mgvargas/imsas/README.md

Amplifier circuit

This project contains an amplifier board and schematics used to amplify the signal from 9 half Wheatstone bridge sensors. All files were created in KiCad.
