mgvargas/imsas/Amplifier_Circuit-V2/SensorArray_v2.pdf

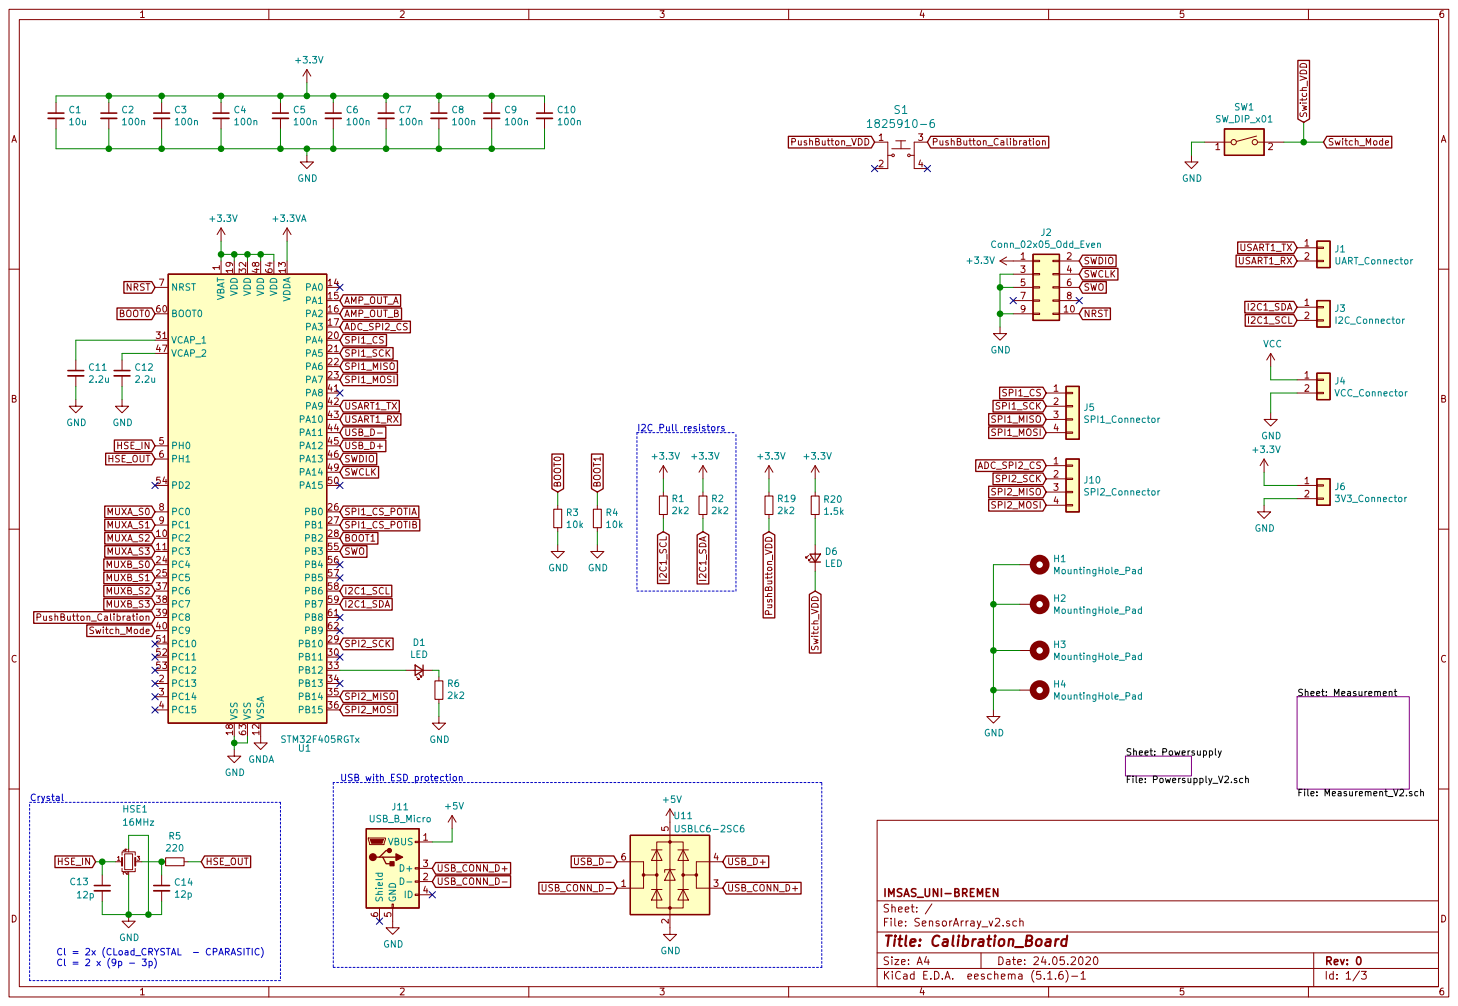
[picture p2: page 1]

1 PC2 10 PC3 11 VSSA 12 VDDA 13 PA0 14 PA1 15 PA2 16 PA3 17 VSS 18 VDD 19 PC13 2 PA4 20 PA5 21 PA6 22 PA7 23 PC4 24 PC5 25 PB0 26 PB1 27 PB2 28 PB10 29 PC14 3 PB11 30 VCAP_1 31 VDD 32 PB12 33 PB13 34 PB14 35 PB15 36 PC6 37 PC7 38 PC8 39 PC15 4 PC9 40 PA8 41 PA9 42 PA10 43 PA11 44 PA12 45 PA13 46 VCAP_2 47 VDD 48 PA14 49 PH0 5 PA15 50 PC10 51 PC11 52 PC12 53 PD2 54 PB3 55 PB4 56 PB5 57 PB6 58 PB7 59 PH1 6 BOOT0 60 PB8 61 PB9 62 VSS 63 VDD 64 NRST 7 PC0 8 PC1 9 U1 STM32F405RGTx R6

Sheet: Measurement File: Measurement_V2.sch Sheet: Powersupply

USB with ESD protection

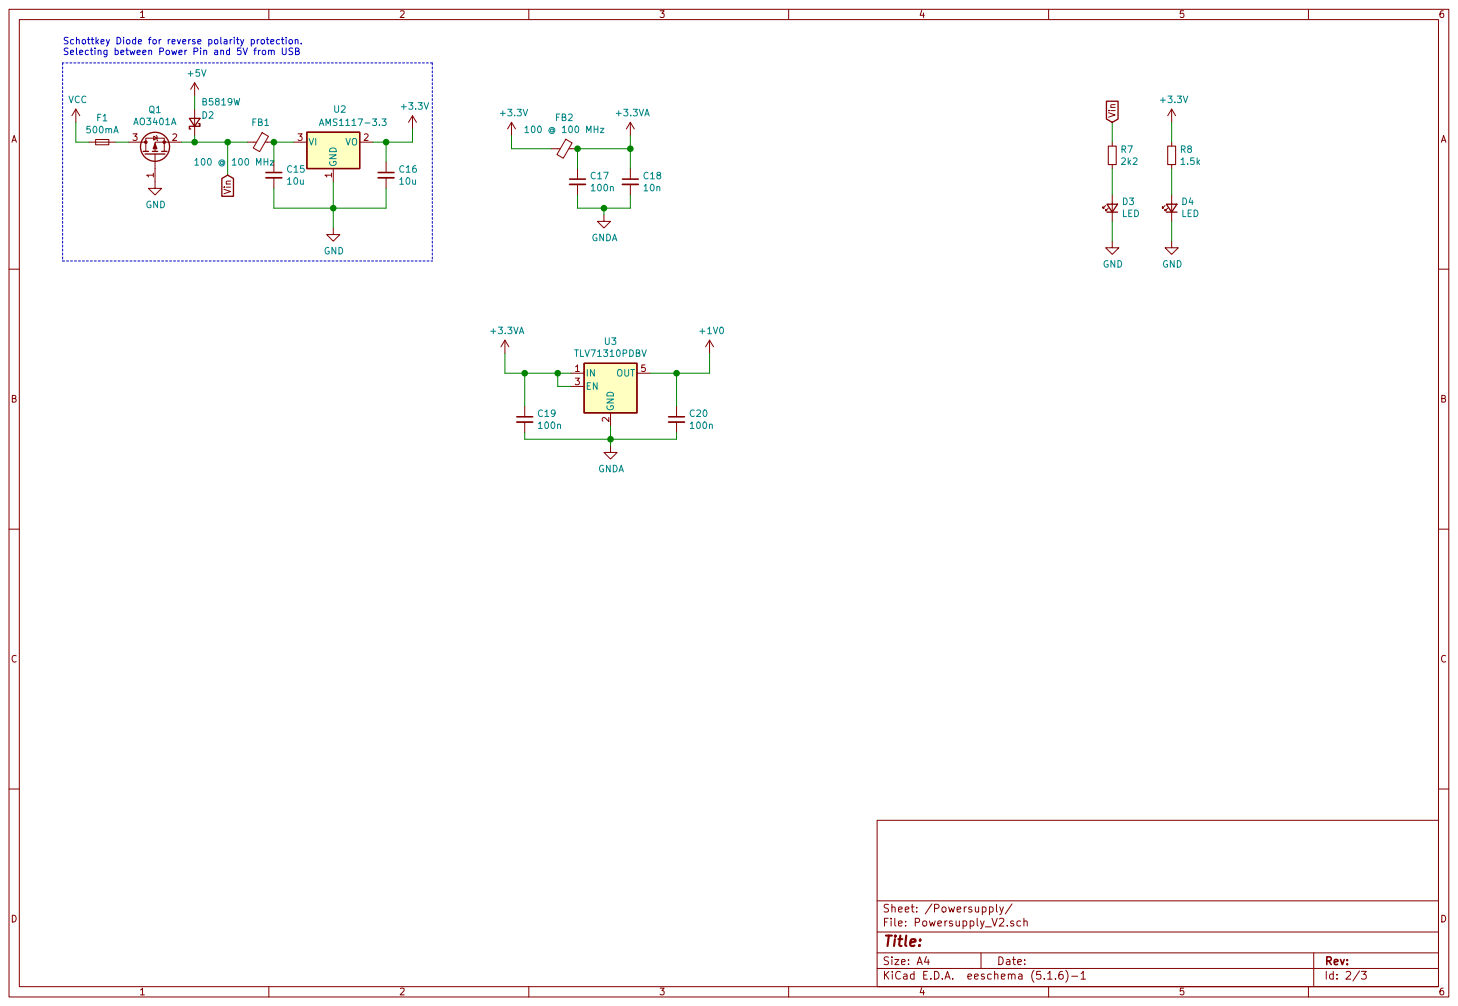
[picture p3: page 2]

Schottkey Diode for reverse polarity protection.
Selecting between Power Pin and 5V from USB

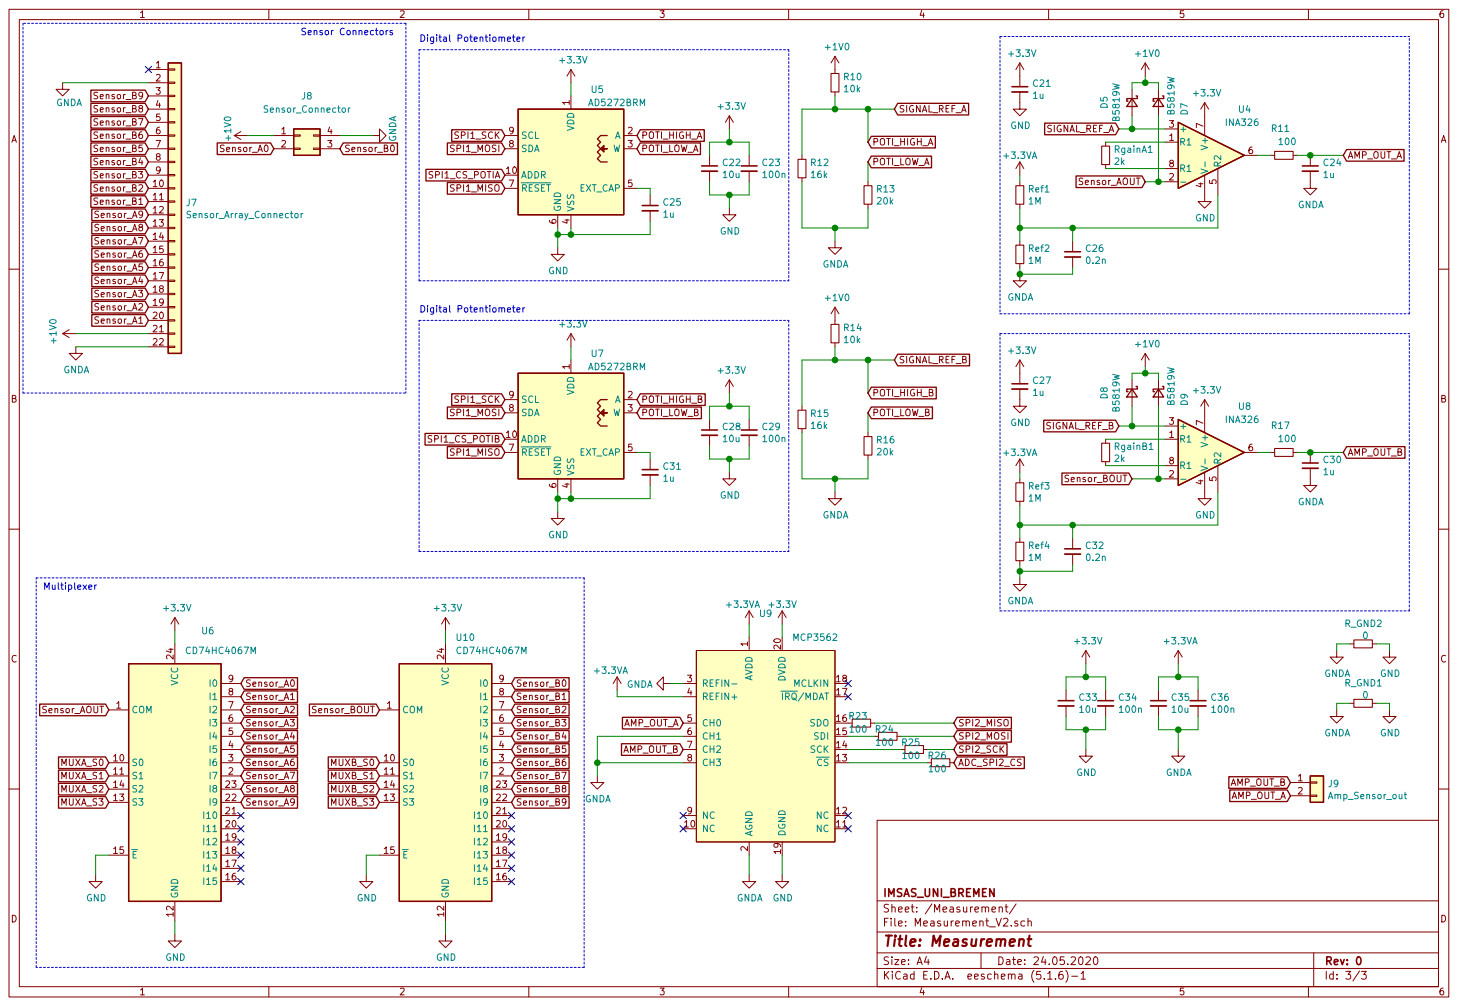
[picture p4: page 3]

2 DVDD 20 REFIN- 3 REFIN+ 4 CH0 5 CH1 6 CH2 7 CH3 8 NC 9 U9 MCP3562

1 NC 10 NC 11 NC 12 CS 13 SCK 14 SDI 15 SDO 16

IMSAS_UNI_BREMEN
File: Measurement_V2.sch Sheet: /Measurement/
Id: 3/3 Title: Measurement
