mgvargas/imsas/Amplifier_Circuit/SensorArray.pdf

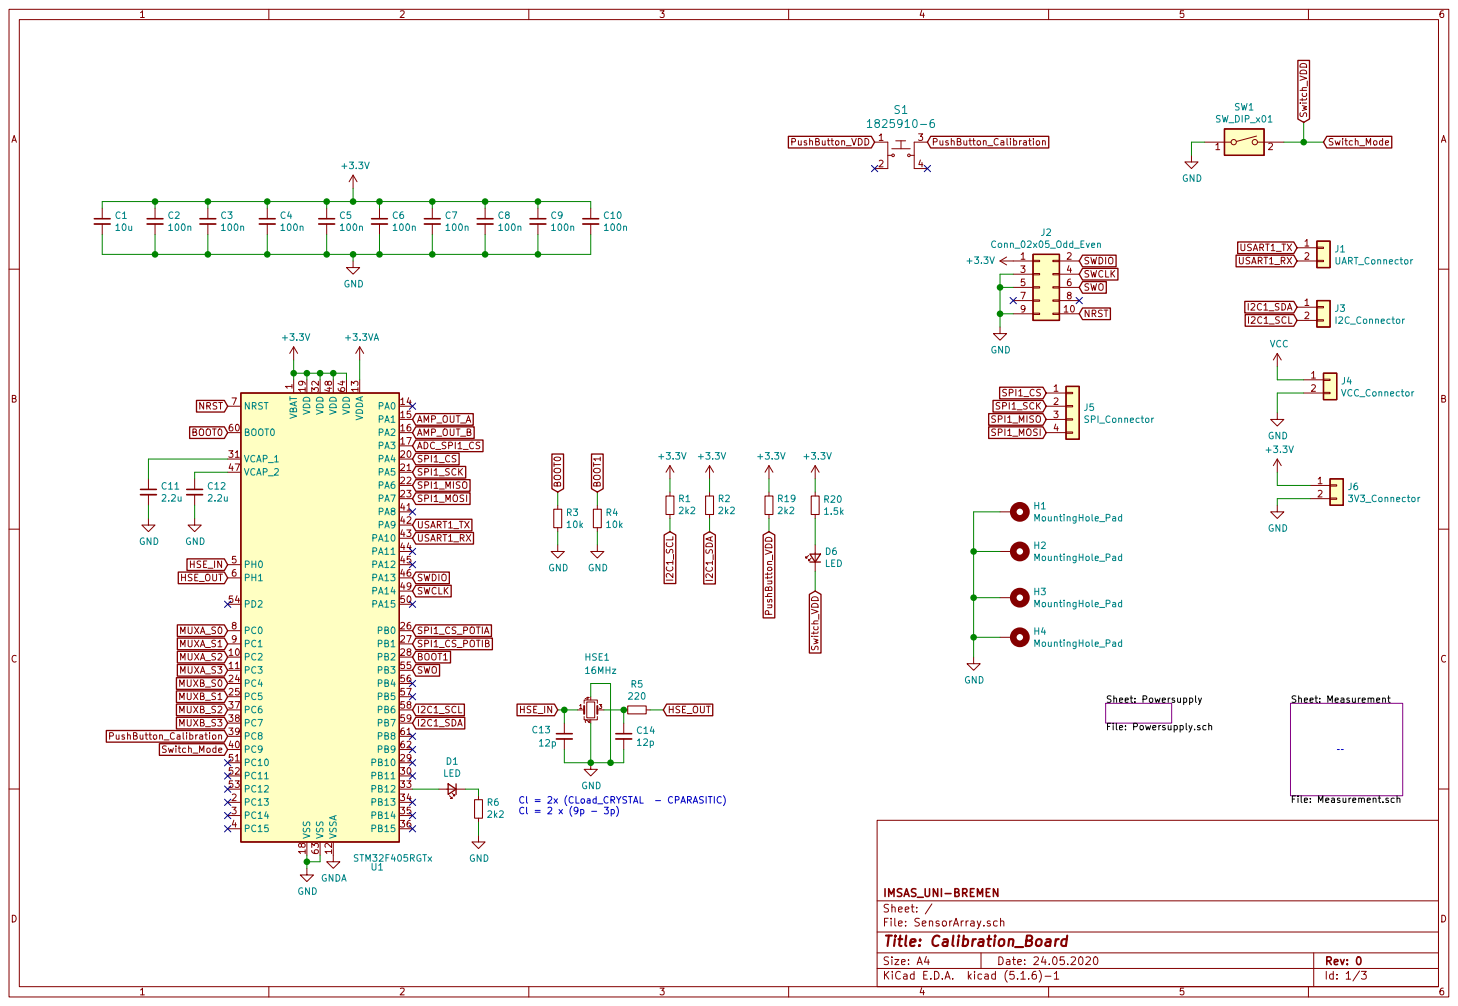
[picture p5: page 1]

1 VCAP_1 31 VCAP_2 47 VDD 19 VDD 32 VDD 48 VDD 64 VDDA 13 VSS 18 VSS 63 VSSA 12 U1 STM32F405RGTx

Sheet: Measurement File: Measurement.sch Sheet: Powersupply

IMSAS_UNI-BREMEN
File: SensorArray.sch Sheet: /
Id: 1/3 Title: Calibration_Board

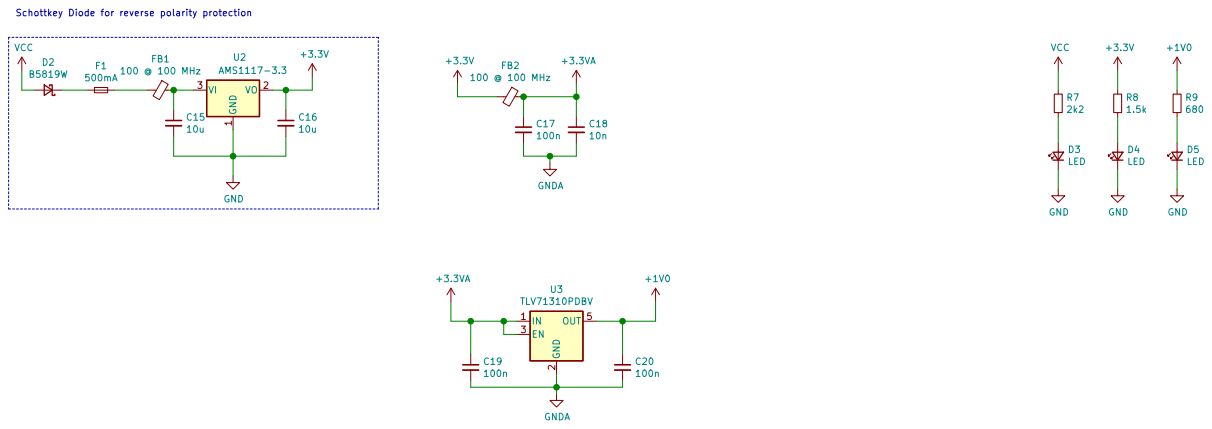
[picture p6: page 2]

Schottkey Diode for reverse polarity protection

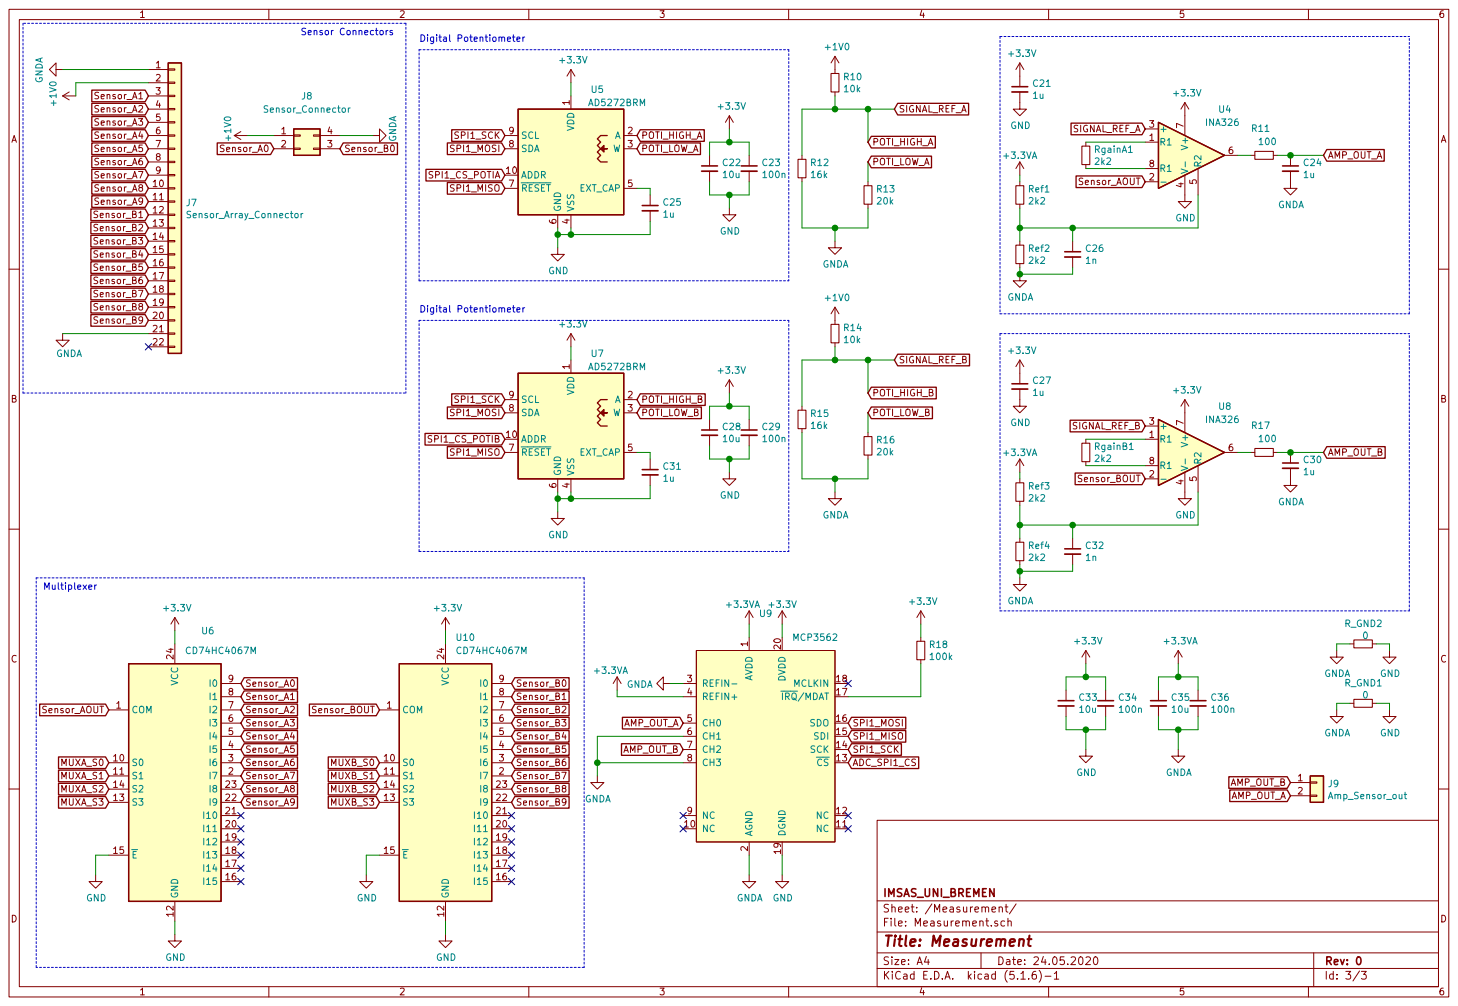
[picture p7: page 3]

2 DVDD 20 REFIN- 3 REFIN+ 4 CH0 5 CH1 6 CH2 7 CH3 8 NC 9 U9 MCP3562 C30

1 NC 10 NC 11 NC 12 CS 13 SCK 14 SDI 15 SDO 16

IMSAS_UNI_BREMEN
Id: 3/3 Title: Measurement File: Measurement.sch Sheet: /Measurement/
