mgvargas/imsas/Amplifier_Circuit/SensorArrayBoard.pdf

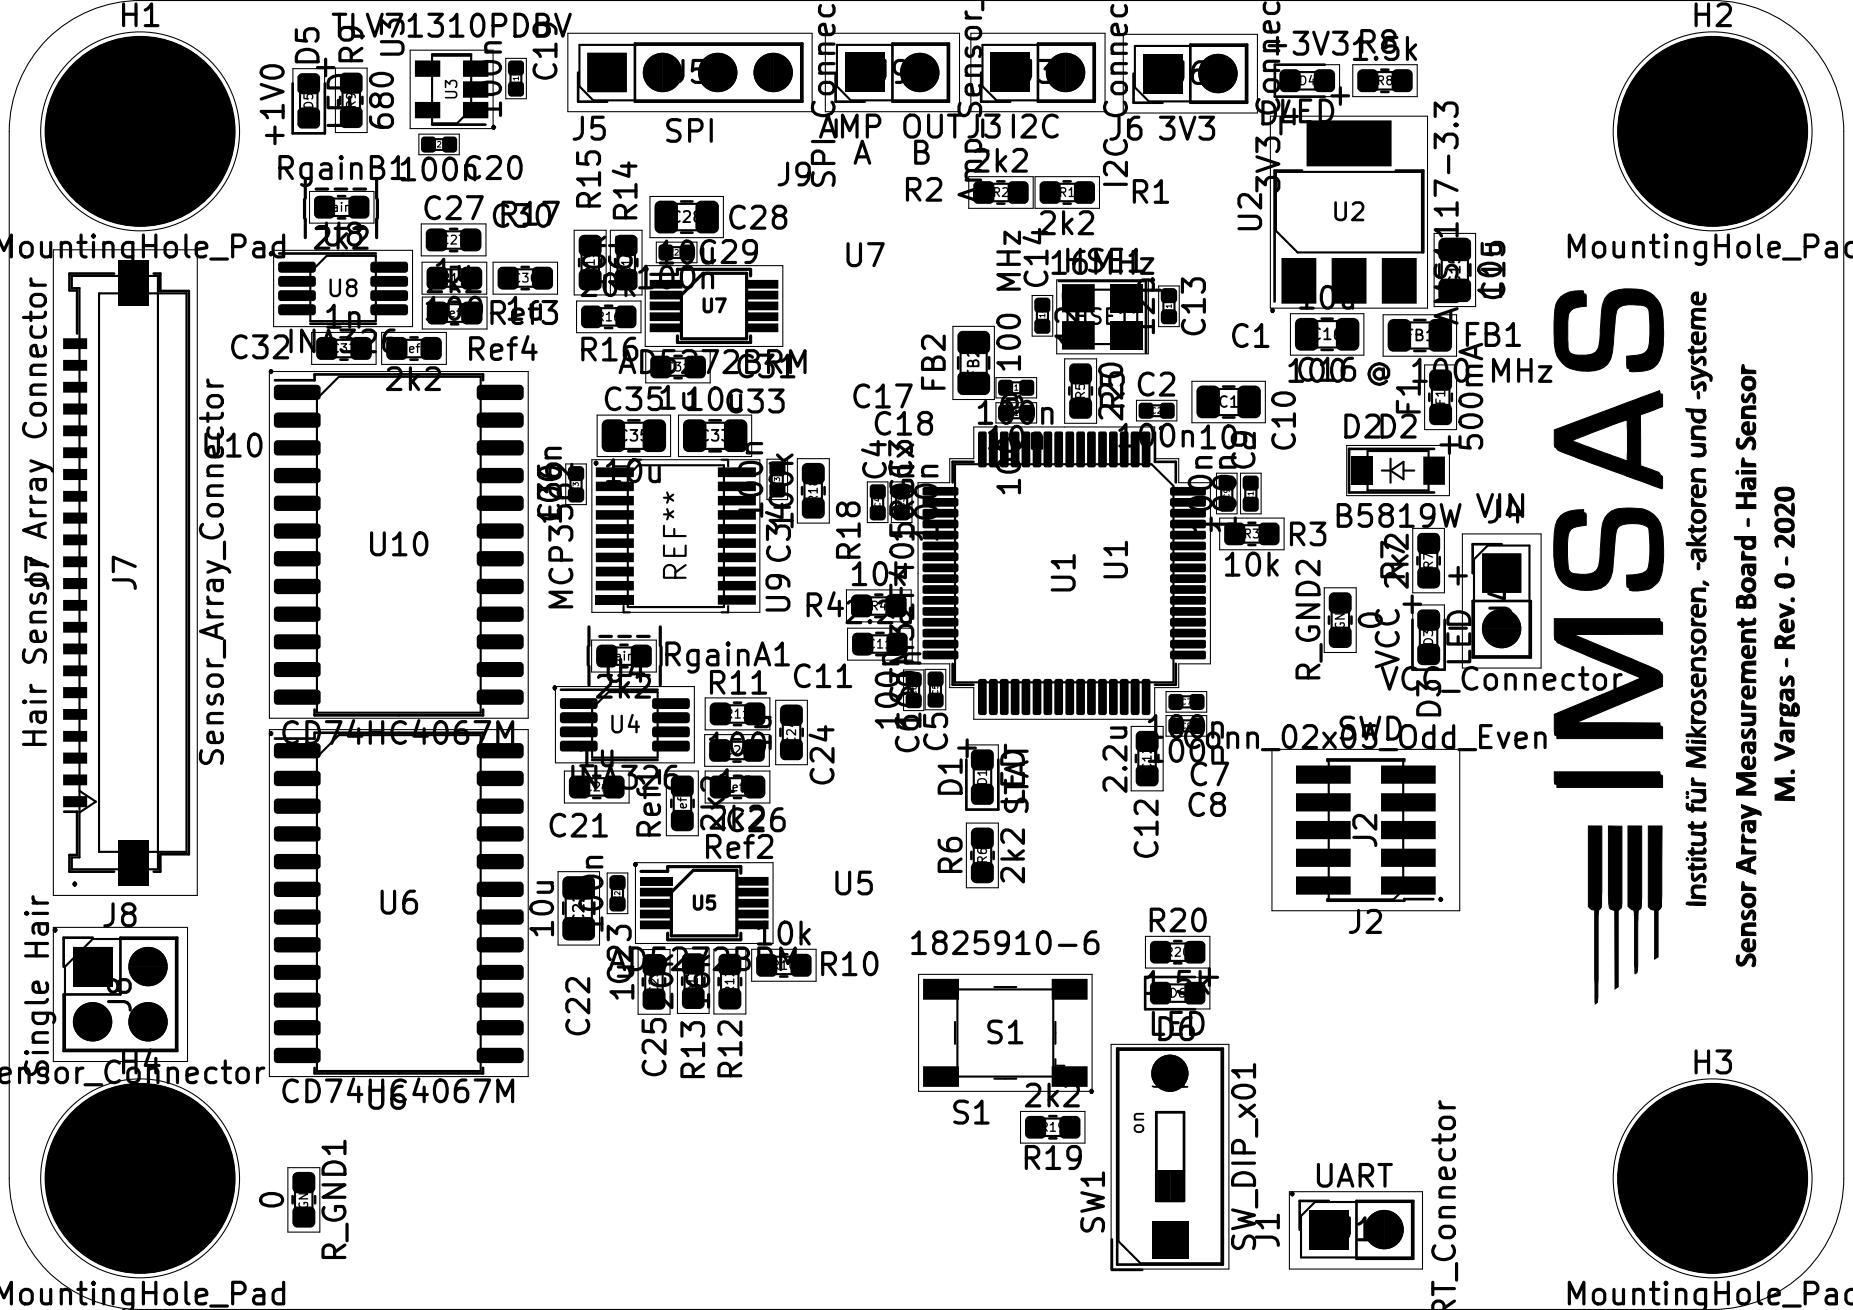
[picture p8: page 1]
