mgvargas/imsas/PCB_Sensor_Array/PCB_Sensor_Array.kicad_pcb

## KiCad design PCB_Sensor_Array/PCB_Sensor_Array.kicad_pcb (2021-01-04)

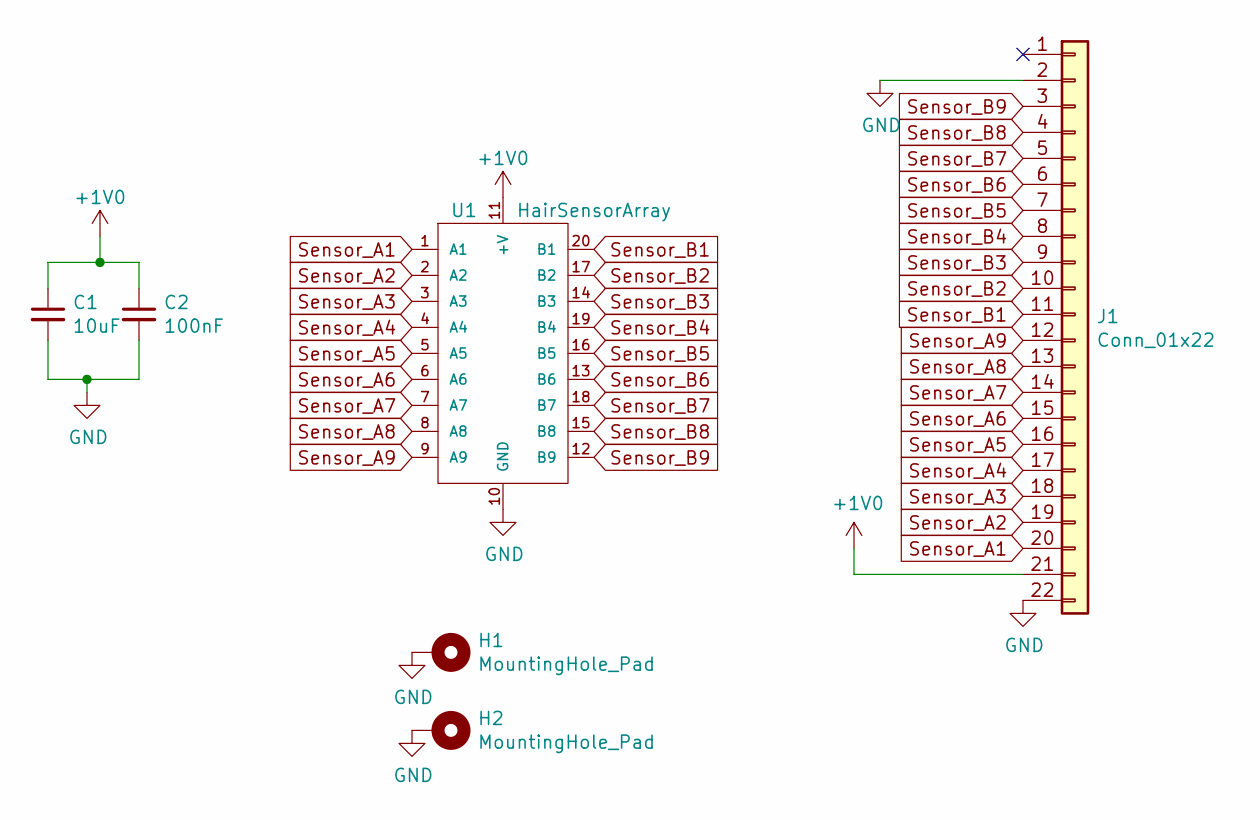
[picture p9: schematic PCB_Sensor_Array.sch]

Parts:
C1: 10uF; C_0603_1608Metric
C2: 100nF; C_0603_1608Metric
H1, H2: MountingHole_Pad; MountingHole_3.2mm_M3_Pad_Via
J1: Conn_01x22; Molex_200528-0220_1x22-1MP_P1.00mm_Horizontal
U1: HairSensorArray; Hair_Sensor_QFP-20_10x10_Pitch0.5mm

Connections:
+1V0: C1.1, C2.1, J1.21, U1.11 (+V)
GND: C1.2, C2.2, H1.1, H2.1, J1.2, J1.22, U1.10 (GND)
Sensor_A1: J1.20, U1.1 (A1)
Sensor_A2: J1.19, U1.2 (A2)
Sensor_A3: J1.18, U1.3 (A3)
Sensor_A4: J1.17, U1.4 (A4)
Sensor_A5: J1.16, U1.5 (A5)
Sensor_A6: J1.15, U1.6 (A6)
Sensor_A7: J1.14, U1.7 (A7)
Sensor_A8: J1.13, U1.8 (A8)
Sensor_A9: J1.12, U1.9 (A9)
Sensor_B1: J1.11, U1.20 (B1)
Sensor_B2: J1.10, U1.17 (B2)
Sensor_B3: J1.9, U1.14 (B3)
Sensor_B4: J1.8, U1.19 (B4)
Sensor_B5: J1.7, U1.16 (B5)
Sensor_B6: J1.6, U1.13 (B6)
Sensor_B7: J1.5, U1.18 (B7)
Sensor_B8: J1.4, U1.15 (B8)
Sensor_B9: J1.3, U1.12 (B9)

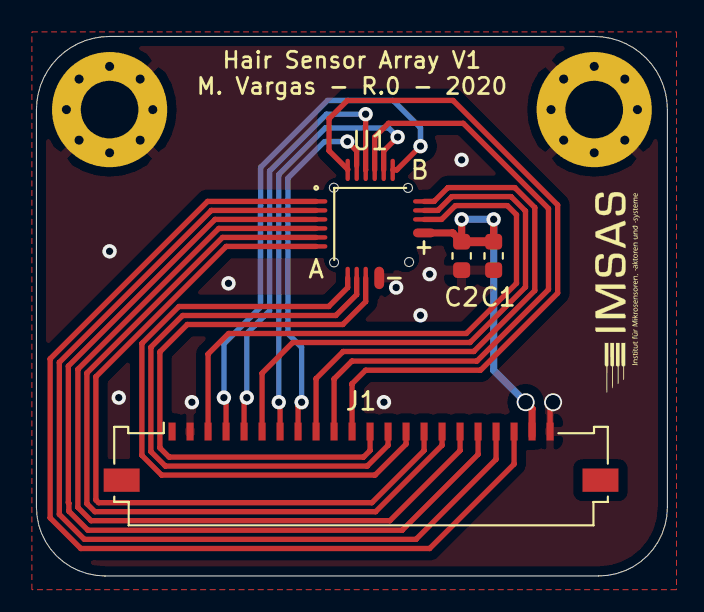
[picture p10: board PCB_Sensor_Array.kicad_pcb from above]

Board: 2 copper layers, 35.1 x 30.0 mm, 6 parts (0 on the bottom side), 20 nets.
