mgvargas/imsas/Amplifier_Circuit-V2/SensorArray_V2.kicad_pcb

## KiCad design Amplifier_Circuit-V2/SensorArray_V2.kicad_pcb (2020-11-30)

Schematic: SensorArray_v2.sch, Calibration_Board

Parts:
C1: 10u; C_0805_2012Metric
C2, C3, C4, C5, C6, C7, C8, C9, C10: 100n; C_0402_1005Metric
C11, C12: 2.2u; C_0603_1608Metric
C13, C14: 12p; C_0402_1005Metric
D1, D6: LED; LED_0603_1608Metric
H1, H2, H3, H4: MountingHole_Pad; MountingHole_4.3mm_M4_Pad_Via
HSE1: 16MHz; Crystal_SMD_3225-4Pin_3.2x2.5mm
J1: UART_Connector; PinSocket_1x02_P2.54mm_Vertical
J2: Conn_02x05_Odd_Even; PinHeader_2x05_P1.27mm_Vertical_SMD
J3: I2C_Connector; PinHeader_1x02_P2.54mm_Vertical
J4: VCC_Connector; PinHeader_1x02_P2.54mm_Vertical
J5: SPI1_Connector; PinHeader_1x04_P2.54mm_Vertical
J6: 3V3_Connector; PinHeader_1x02_P2.54mm_Vertical
J10: SPI2_Connector; PinHeader_1x04_P2.54mm_Vertical
J11: USB_B_Micro; USB_Micro-B_Molex-105133-0001
R1, R2, R6, R19: 2k2; R_0603_1608Metric
R3, R4: 10k; R_0603_1608Metric
R5: 220; R_0603_1608Metric
R20: 1.5k; R_0603_1608Metric
S1: 1825910-6; SMD-4_5x4.4mm_P4mm; MPN 1825910-6; Digi-Key_PN 450-1650-ND
SW1: SW_DIP_x01; SW_DIP_SPSTx01_Slide_9.78x4.72mm_W7.62mm_P2.54mm
U1: STM32F405RGTx; LQFP-64_10x10mm_P0.5mm
U11: USBLC6-2SC6; SOT-23-6

Connections:
+3.3VA: U1.13 (VDDA); also elsewhere on the board
+3V3: C1.1, C2.1, C3.1, C4.1, C5.1, C6.1, C7.1, C8.1, C9.1, C10.1, J2.1, J6.1, R1.2, R2.2, R19.2, R20.1, U1.1 (VBAT), U1.19 (VDD), U1.32 (VDD), U1.48 (VDD), U1.64 (VDD); also elsewhere on the board
+5V: J11.1, U11.5; also elsewhere on the board
ADC_SPI2_CS: J10.1, U1.17 (PA3); also elsewhere on the board
AMP_OUT_A: U1.15 (PA1); also elsewhere on the board
AMP_OUT_B: U1.16 (PA2); also elsewhere on the board
BOOT0: R3.1, U1.60 (BOOT0)
BOOT1: R4.1, U1.28 (PB2)
GND: C1.2, C2.2, C3.2, C4.2, C5.2, C6.2, C7.2, C8.2, C9.2, C10.2, C11.2, C12.2, C13.2, C14.2, H1.1, H2.1, H3.1, H4.1, HSE1.2, HSE1.4, J2.3, J2.5, J2.9, J4.2, J6.2, J11.5, R3.2, R4.2, R6.1, SW1.1, U1.18 (VSS), U1.63 (VSS), U11.2; also elsewhere on the board
GNDA: U1.12 (VSSA); also elsewhere on the board
HSE_IN: C13.1, HSE1.1, U1.5 (PH0)
HSE_OUT: R5.1, U1.6 (PH1)
I2C1_SCL: J3.2, R1.1, U1.58 (PB6)
I2C1_SDA: J3.1, R2.1, U1.59 (PB7)
MUXA_S0: U1.8 (PC0); also elsewhere on the board
MUXA_S1: U1.9 (PC1); also elsewhere on the board
MUXA_S2: U1.10 (PC2); also elsewhere on the board
MUXA_S3: U1.11 (PC3); also elsewhere on the board
MUXB_S0: U1.24 (PC4); also elsewhere on the board
MUXB_S1: U1.25 (PC5); also elsewhere on the board
MUXB_S2: U1.37 (PC6); also elsewhere on the board
MUXB_S3: U1.38 (PC7); also elsewhere on the board
NRST: J2.10, U1.7 (NRST)
unnamed: C11.1, U1.31 (VCAP_1)
unnamed: C12.1, U1.47 (VCAP_2)
unnamed: C14.1, HSE1.3, R5.2
unnamed: D1.1 (K), R6.2
unnamed: D1.2 (A), U1.33 (PB12)
unnamed: D6.2 (A), R20.2
PushButton_Calibration: S1.3, U1.39 (PC8)
PushButton_VDD: R19.1, S1.1
SPI1_CS: J5.1, U1.20 (PA4)
SPI1_CS_POTIA: U1.26 (PB0); also elsewhere on the board
SPI1_CS_POTIB: U1.27 (PB1); also elsewhere on the board
SPI1_MISO: J5.3, U1.22 (PA6); also elsewhere on the board
SPI1_MOSI: J5.4, U1.23 (PA7); also elsewhere on the board
SPI1_SCK: J5.2, U1.21 (PA5); also elsewhere on the board
SPI2_MISO: J10.3, U1.35 (PB14); also elsewhere on the board
SPI2_MOSI: J10.4, U1.36 (PB15); also elsewhere on the board
SPI2_SCK: J10.2, U1.29 (PB10); also elsewhere on the board
SWCLK: J2.4, U1.49 (PA14)
SWDIO: J2.2, U1.46 (PA13)
SWO: J2.6, U1.55 (PB3)
Switch_Mode: D6.1 (K), SW1.2, U1.40 (PC9)
USART1_RX: J1.2, U1.43 (PA10)
USART1_TX: J1.1, U1.42 (PA9)
USB_CONN_D+: J11.3, U11.3
USB_CONN_D-: J11.2, U11.1
USB_D+: U1.45 (PA12), U11.4
USB_D-: U1.44 (PA11), U11.6
VCC: J4.1; also elsewhere on the board

Notes on the sheet:
Cl = 2x (CLoad_CRYSTAL - CPARASITIC) Cl = 2 x (9p - 3p)
I2C Pull resistors
Crystal
USB with ESD protection

Schematic: Powersupply_V2.sch

Parts:
C15, C16: 10u; C_0805_2012Metric
C17, C19, C20: 100n; C_0402_1005Metric
C18: 10n; C_0402_1005Metric
D2: B5819W; D_SOD-123
D3, D4: LED; LED_0603_1608Metric
F1: 500mA; Fuse_0603_1608Metric
FB1, FB2: 100 @ 100 MHz; L_0805_2012Metric
Q1: AO3401A; SOT-23
R7: 2k2; R_0603_1608Metric
R8: 1.5k; R_0603_1608Metric
U2: AMS1117-3.3; SOT-223-3_TabPin2
U3: TLV71310PDBV; SOT-23-5

Connections:
+1V0: C20.1, U3.5 (OUT); also elsewhere on the board
+3.3VA: C17.1, C18.1, C19.1, FB2.1, U3.1 (IN), U3.3 (EN); also elsewhere on the board
+3V3: C16.1, FB2.2, R8.1, U2.2 (VO); also elsewhere on the board
+5V: D2.2 (A); also elsewhere on the board
GND: C15.2, C16.2, D3.1 (K), D4.1 (K), Q1.1, U2.1 (GND); also elsewhere on the board
GNDA: C17.2, C18.2, C19.2, C20.2, U3.2 (GND); also elsewhere on the board
unnamed: C15.1, FB1.1, U2.3 (VI)
unnamed: D3.2 (A), R7.2
unnamed: D4.2 (A), R8.2
unnamed: F1.2, Q1.3
VCC: F1.1; also elsewhere on the board
Vin: D2.1 (K), FB1.2, Q1.2, R7.1

Notes on the sheet:
Schottkey Diode for reverse polarity protection. Selecting between Power Pin and 5V from USB

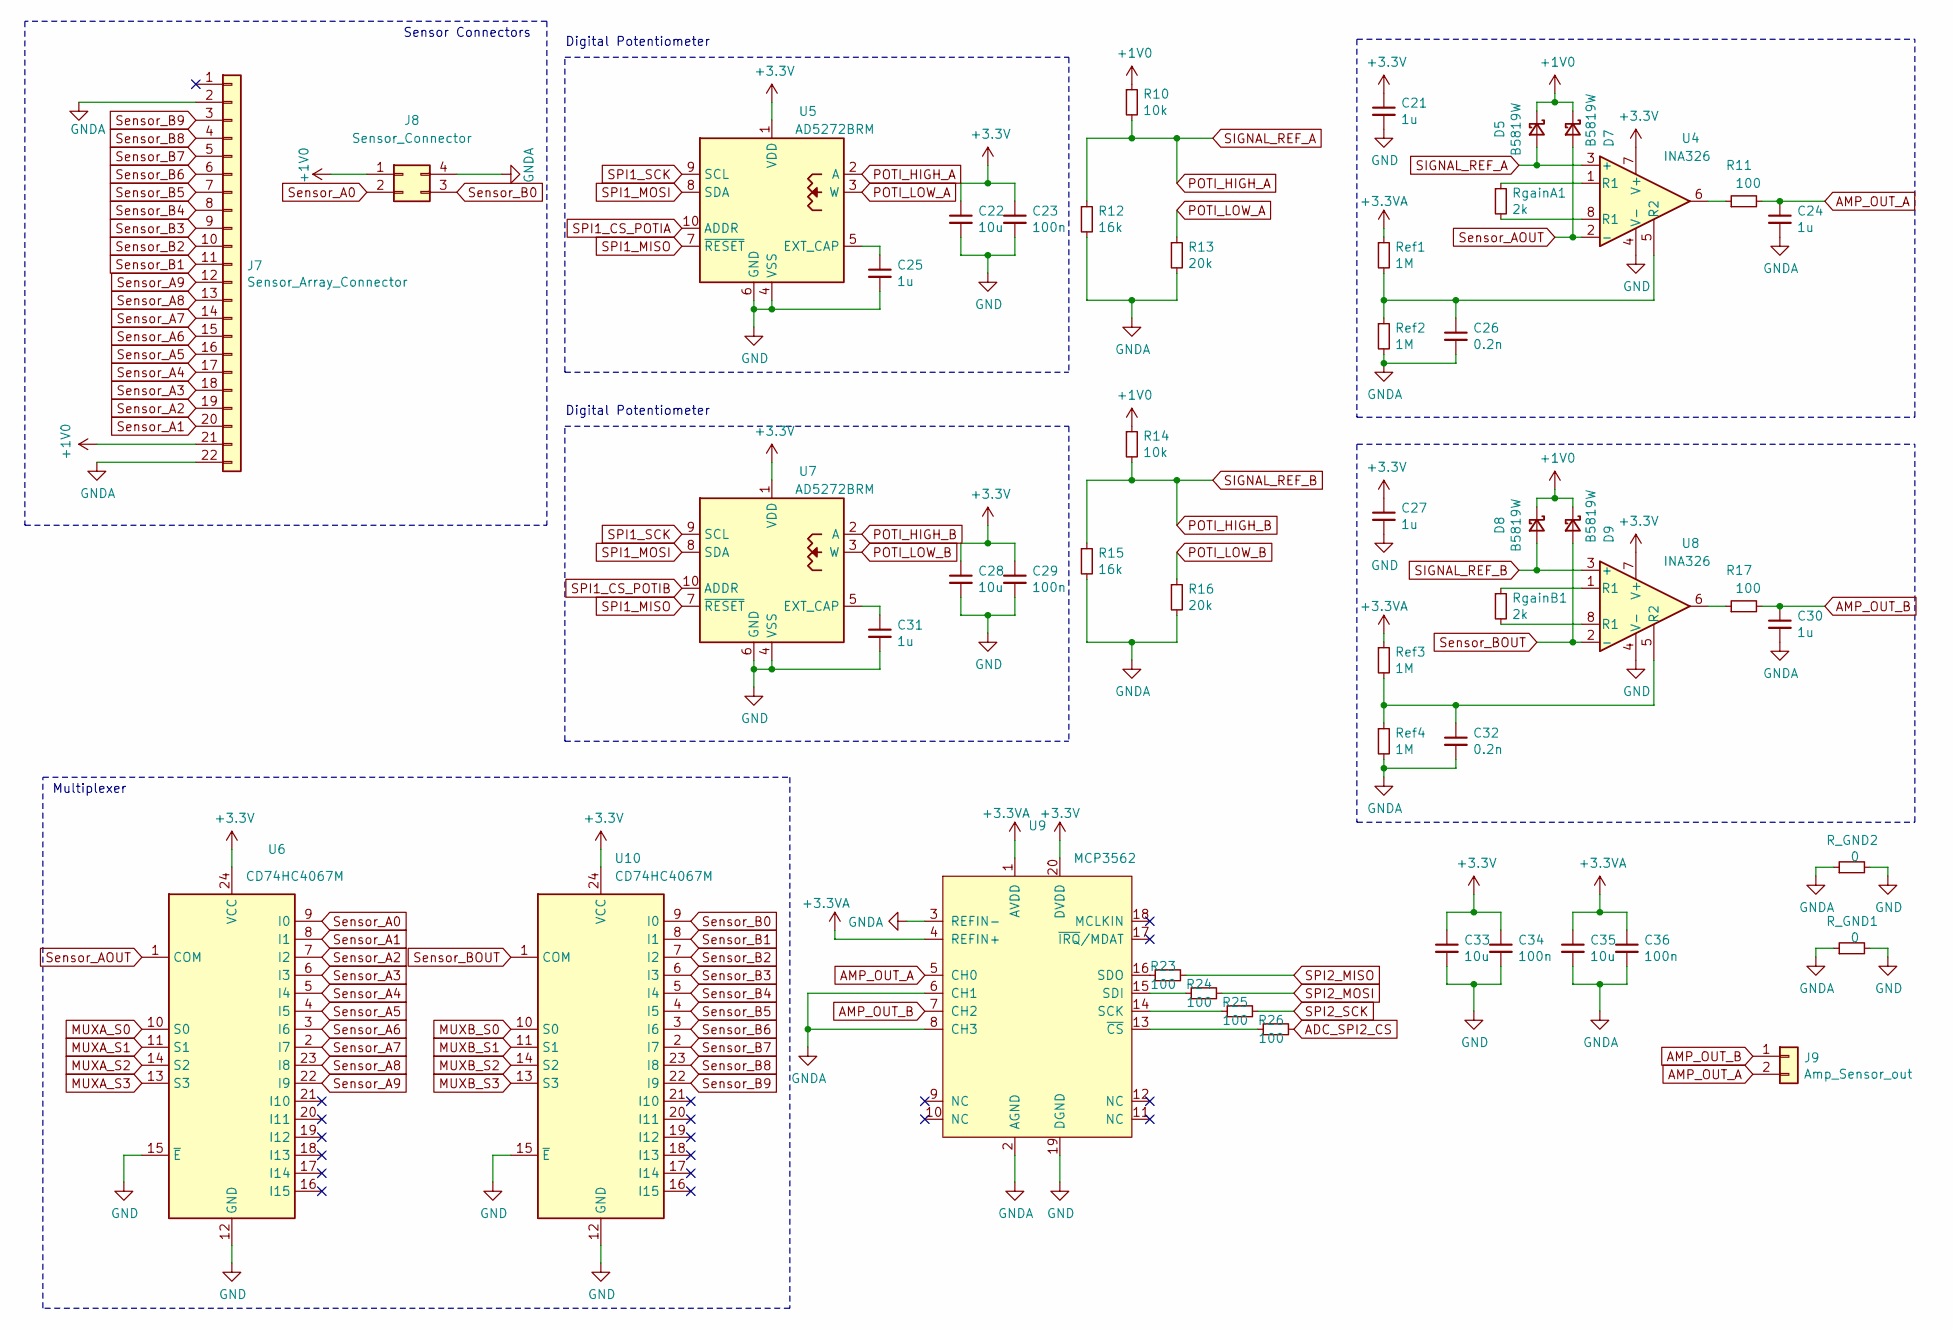
[picture p11: schematic Measurement_V2.sch, Measurement]

Parts:
C21, C24, C25, C27, C30, C31: 1u; C_0603_1608Metric
C22, C28, C33, C35: 10u; C_0805_2012Metric
C23, C29, C34, C36: 100n; C_0402_1005Metric
C26, C32: 0.2n; C_0603_1608Metric
D5, D7, D8, D9: B5819W; D_SOD-123
J7: Sensor_Array_Connector; Molex_200528-0220_1x22-1MP_P1.00mm_Horizontal
J8: Sensor_Connector; PinHeader_2x02_P2.54mm_Vertical
J9: Amp_Sensor_out; PinHeader_1x02_P2.54mm_Vertical
R10, R14: 10k; R_0603_1608Metric
R11, R17: 100; R_0603_1608Metric
R12, R15: 16k; R_0603_1608Metric
R13, R16: 20k; R_0603_1608Metric
R23, R24, R25, R26: 100; R_0402_1005Metric
R_GND1, R_GND2: 0; R_0603_1608Metric
Ref1, Ref2, Ref3, Ref4: 1M; R_0603_1608Metric
RgainA1: 2k; R_0603_1608Metric
RgainB1: 2k; R_0603_1608Metric
U4, U8: INA326; MSOP-8_3x3mm_P0.65mm
U5, U7: AD5272BRM; MSOP-10_3x3mm_P0.5mm
U6, U10: CD74HC4067M; SOIC-24W_7.5x15.4mm_P1.27mm
U9: MCP3562; TSSOP-20_W4.4mm

Connections:
+1V0: D5.1 (K), D7.1 (K), D8.1 (K), D9.1 (K), J7.21, J8.1, R10.1, R14.1; also elsewhere on the board
+3.3VA: C35.1, C36.1, Ref1.1, Ref3.1, U9.1 (AVDD), U9.4 (REFIN+); also elsewhere on the board
+3V3: C21.1, C22.1, C23.1, C27.1, C28.1, C29.1, C33.1, C34.1, U4.7 (V+), U5.1 (VDD), U6.24 (VCC), U7.1 (VDD), U8.7 (V+), U9.20 (DVDD), U10.24 (VCC); also elsewhere on the board
ADC_SPI2_CS: R26.2; also elsewhere on the board
AMP_OUT_A: C24.1, J9.2, R11.2, U9.5 (CH0); also elsewhere on the board
AMP_OUT_B: C30.1, J9.1, R17.2, U9.7 (CH2); also elsewhere on the board
GND: C21.2, C22.2, C23.2, C25.2, C27.2, C28.2, C29.2, C31.2, C33.2, C34.2, R_GND1.2, R_GND2.2, U4.4 (V-), U5.4 (VSS), U5.6 (GND), U6.12 (GND), U6.15 (~E), U7.4 (VSS), U7.6 (GND), U8.4 (V-), U9.19 (DGND), U10.12 (GND), U10.15 (~E); also elsewhere on the board
GNDA: C24.2, C26.2, C30.2, C32.2, C35.2, C36.2, J7.2, J7.22, J8.4, R12.2, R13.2, R15.2, R16.2, R_GND1.1, R_GND2.1, Ref2.2, Ref4.2, U9.2 (AGND), U9.3 (REFIN-), U9.6 (CH1), U9.8 (CH3); also elsewhere on the board
MUXA_S0: U6.10 (S0); also elsewhere on the board
MUXA_S1: U6.11 (S1); also elsewhere on the board
MUXA_S2: U6.14 (S2); also elsewhere on the board
MUXA_S3: U6.13 (S3); also elsewhere on the board
MUXB_S0: U10.10 (S0); also elsewhere on the board
MUXB_S1: U10.11 (S1); also elsewhere on the board
MUXB_S2: U10.14 (S2); also elsewhere on the board
MUXB_S3: U10.13 (S3); also elsewhere on the board
unnamed: C25.1, U5.5 (EXT_CAP)
unnamed: C26.1, Ref1.2, Ref2.1, U4.5 (R2)
unnamed: C31.1, U7.5 (EXT_CAP)
unnamed: C32.1, Ref3.2, Ref4.1, U8.5 (R2)
unnamed: R11.1, U4.6
unnamed: R17.1, U8.6
unnamed: R23.1, U9.16 (SDO)
unnamed: R24.1, U9.15 (SDI)
unnamed: R25.1, U9.14 (SCK)
unnamed: R26.1, U9.13 (~CS~)
unnamed: RgainA1.1, U4.1 (R1)
unnamed: RgainA1.2, U4.8 (R1)
unnamed: RgainB1.1, U8.1 (R1)
unnamed: RgainB1.2, U8.8 (R1)
POTI_HIGH_A: D5.2 (A), R10.2, R12.1, U4.3 (+), U5.2 (A)
POTI_HIGH_B: D8.2 (A), R14.2, R15.1, U7.2 (A), U8.3 (+)
POTI_LOW_A: R13.1, U5.3 (W)
POTI_LOW_B: R16.1, U7.3 (W)
SPI1_CS_POTIA: U5.10 (ADDR); also elsewhere on the board
SPI1_CS_POTIB: U7.10 (ADDR); also elsewhere on the board
SPI1_MISO: U5.7 (~RESET), U7.7 (~RESET); also elsewhere on the board
SPI1_MOSI: U5.8 (SDA), U7.8 (SDA); also elsewhere on the board
SPI1_SCK: U5.9 (SCL), U7.9 (SCL); also elsewhere on the board
SPI2_MISO: R23.2; also elsewhere on the board
SPI2_MOSI: R24.2; also elsewhere on the board
SPI2_SCK: R25.2; also elsewhere on the board
Sensor_A0: J8.2, U6.9 (I0)
Sensor_A1: J7.20, U6.8 (I1)
Sensor_A2: J7.19, U6.7 (I2)
Sensor_A3: J7.18, U6.6 (I3)
Sensor_A4: J7.17, U6.5 (I4)
Sensor_A5: J7.16, U6.4 (I5)
Sensor_A6: J7.15, U6.3 (I6)
Sensor_A7: J7.14, U6.2 (I7)
Sensor_A8: J7.13, U6.23 (I8)
Sensor_A9: J7.12, U6.22 (I9)
Sensor_AOUT: D7.2 (A), U4.2 (-), U6.1 (COM)
Sensor_B0: J8.3, U10.9 (I0)
Sensor_B1: J7.11, U10.8 (I1)
Sensor_B2: J7.10, U10.7 (I2)
Sensor_B3: J7.9, U10.6 (I3)
Sensor_B4: J7.8, U10.5 (I4)
Sensor_B5: J7.7, U10.4 (I5)
Sensor_B6: J7.6, U10.3 (I6)
Sensor_B7: J7.5, U10.2 (I7)
Sensor_B8: J7.4, U10.23 (I8)
Sensor_B9: J7.3, U10.22 (I9)
Sensor_BOUT: D9.2 (A), U8.2 (-), U10.1 (COM)

Notes on the sheet:
Digital Potentiometer
Sensor Connectors
Multiplexer

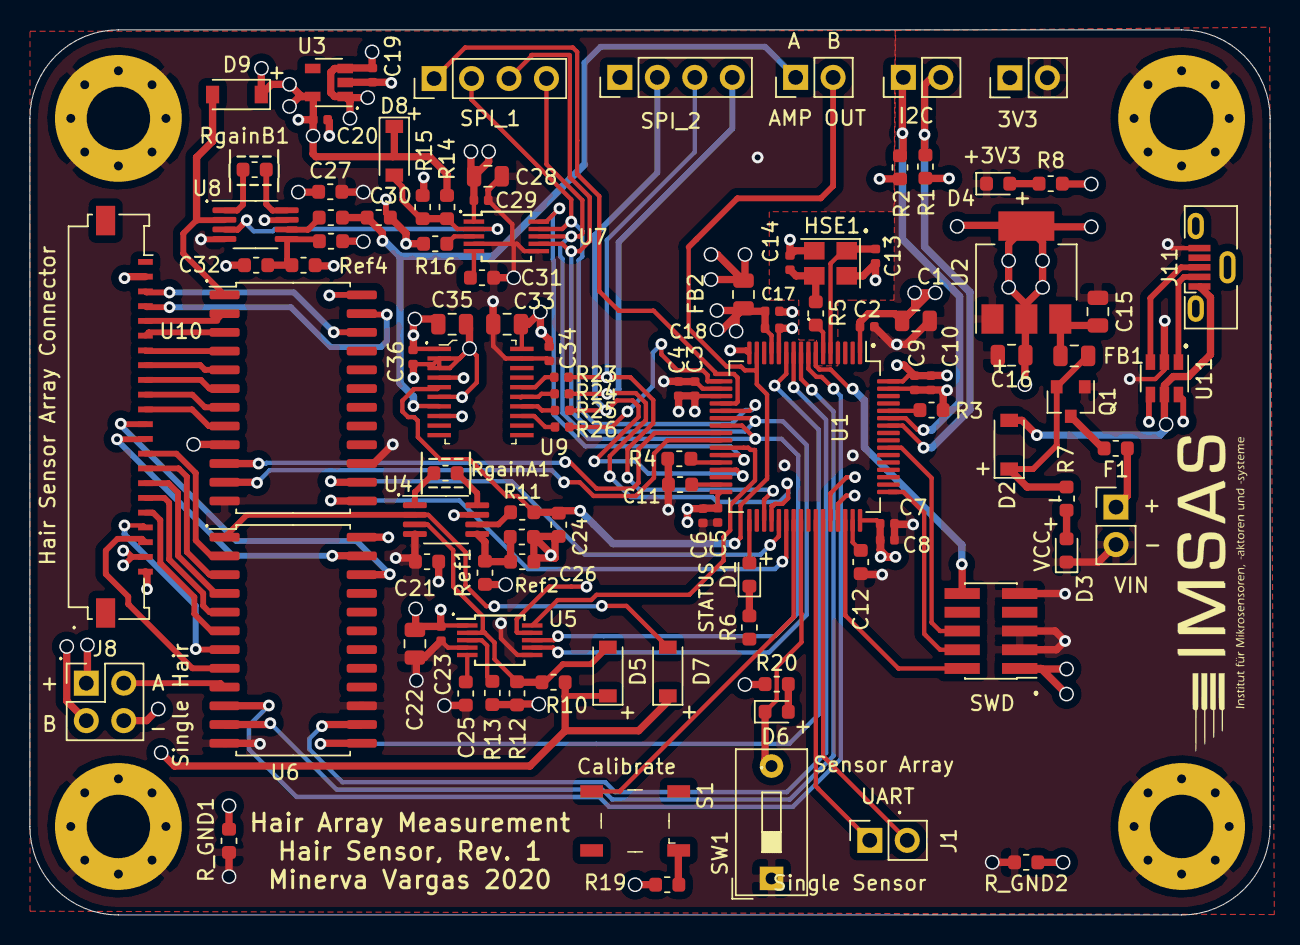
[picture p12: board SensorArray_V2.kicad_pcb from above]

Board: 4 copper layers, 84.1 x 60.0 mm, 108 parts (0 on the bottom side), 97 nets.
