mgvargas/imsas/Code/STM32_Files/SensorArray/Core/Src/main.c

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
/* Includes ------------------------------------------------------------------*/
#include "main.h"
#include "usb_device.h"

/* USER CODE BEGIN Includes */
#include "CD74HC4067.h"		// Multiplexer
#include "ADC.h"			// ADC
#include "AD5270.h"			// Digital potentiometer
#include "calibration.h"
#include "command.h"
#include "math.h"
#include "usbd_cdc_if.h"
#include "string.h"
/* USER CODE END Includes */

ADC_HandleTypeDef hadc1;
ADC_HandleTypeDef hadc2;

I2C_HandleTypeDef hi2c1;

SPI_HandleTypeDef hspi1;
SPI_HandleTypeDef hspi2;

UART_HandleTypeDef huart1;

/* USER CODE BEGIN PV */
usb_buffer usb_data;
/* USER CODE END PV */

void SystemClock_Config(void);
static void MX_GPIO_Init(void);
static void MX_I2C1_Init(void);
static void MX_SPI1_Init(void);
static void MX_ADC1_Init(void);
static void MX_ADC2_Init(void);
static void MX_USART1_UART_Init(void);
static void MX_SPI2_Init(void);
/* USER CODE BEGIN 0 */
/////////////////////////// Global Variables //////////////////////////////////
//uint8_t POTIA[2] = {0x07, 0xff};
// ADC Values
//uint8_t cmd_ADC[2];
uint8_t ADC_RX_buffer[3];
int raw_ADC;
int i;

// Read sensors
float Sensor_values_A[10];
float Sensor_values_B[10];
/////////////////////////// end Global Variables //////////////////////////////////
/* USER CODE END 0 */

/**
  * @brief  The application entry point.
  * @retval int
  */
int main(void)
{
  /* USER CODE BEGIN 1 */
	// Variable definition
	//uint8_t UART_Data[25] = "Test UART communication :";

  /* USER CODE END 1 */

  /* MCU Configuration--------------------------------------------------------*/

  /* Reset of all peripherals, Initializes the Flash interface and the Systick. */
  HAL_Init();

  /* Configure the system clock */
  SystemClock_Config();

  /* USER CODE BEGIN SysInit */
	HAL_Delay(1000);
  /* USER CODE END SysInit */

  /* Initialize all configured peripherals */
  MX_GPIO_Init();
  MX_I2C1_Init();
  MX_SPI1_Init();
  MX_ADC1_Init();
  MX_ADC2_Init();
  MX_USART1_UART_Init();
  MX_SPI2_Init();
  MX_USB_DEVICE_Init();
  /* USER CODE BEGIN 2 */
	HAL_Delay(2000);
	mux_channel(0);  // Select mux channel (for both mux)
	HAL_Delay(200);

	// Configure ADC
	config_ADC(0x0D,0xA5); // Lock register: Write access is allowed on the full register map
	config_ADC(0x01,0xE3); // Conversion mode
	config_ADC(0x02,0x0C); // Oversampling rate
	config_ADC(0x04,0xC0); // Configure conversion and gain
	config_ADC(0x05,0x04); // Configure IRQ register, only a test
	config_ADC(0x06,ADC_A_Select); // Select ADC A
	config_ADC2(0x07); // Scan register


	HAL_Delay(100);


  /* USER CODE END 2 */

  /* Infinite loop */
  /* USER CODE BEGIN WHILE */
	while (1)
	{
		// Start SPI communication with Digital Poti (AD5270) SPI1_CS_POTIA_Pin
		Poti_SPI_Init(&hspi1); // Initialize digital potentiometer
		HAL_Delay(20);
		calibrate_potis(&hspi1);

		// Mode single sensor
		if (HAL_GPIO_ReadPin(GPIOC, Switch_Mode_Pin)){
			HAL_GPIO_WritePin(GPIOB, LED_STATUS_Pin, GPIO_PIN_SET);
			read_single_sensor();
		}
		// Mode sensor array
		else{
			HAL_GPIO_WritePin(GPIOB, LED_STATUS_Pin, GPIO_PIN_RESET);
			read_sensor_array();
		}
		// Check if a new command came over USB
		if(usb_data.new_data == 1)
		{
			decode_command(&usb_data.data[0]);
			usb_data_reset();
		}
		HAL_Delay(20);

		// Send test message UART
		/*HAL_UART_Transmit(&huart1, UART_Data,25,20); // Handle_type, data, length, timeout
		HAL_Delay(200);
		HAL_UART_Transmit(&huart1, ADC_RX_buffer, 3, 20);
		//HAL_Delay(10);
		//HAL_UART_Transmit(&huart1, Data,11,20); // Handle_type, data, length, timeout */


	}

    /* USER CODE END WHILE */

}

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
/* USER CODE BEGIN 4 */


////////////////////////////////// Read sensor: Array or single sensor mode ///////////////////

void read_sensor_array(void){
	char usb_array_A[85] = "Array_A ";
	char usb_array_B[85] = "Array_B ";
	char values_A[75];
	char values_B[75];
	uint8_t *ADC_RX_buffer_pointer;
	int sensor;

	while(1){
		char *posA = values_A;

		// For channel A
		config_ADC(0x6, ADC_A_Select);
		//HAL_Delay(5);
		for (sensor=1; sensor <= 9; sensor++){
			// Set calibrated potentiometer values
			mux_channel(sensor);
			Poti_Set_RDAC(Potentiometer_values_A[sensor], 'A', &hspi1);

			//Read ADC
			ADC_RX_buffer_pointer = read_ADC(0x00);
			Sensor_values_A[sensor] = voltage_ADC(ADC_RX_buffer_pointer);

			// Save value as string array
			if (sensor<9)
				posA += sprintf(posA, "%.4f, ", Sensor_values_A[sensor]);
			else
				posA += sprintf(posA, "%.4f\n", Sensor_values_A[sensor]);
		}
		// Send array
		strcat(usb_array_A, values_A);
		CDC_Transmit_FS((uint8_t *) usb_array_A, strlen(usb_array_A));
		strcpy(usb_array_A, "Array_A "); // Reset string value

		// For channel B
		char *posB = values_B;
		config_ADC(0x6, ADC_B_Select);
		//HAL_Delay(5);
		for (sensor=1; sensor <= 9; sensor++){
			// Set calibrated potentiometer values
			mux_channel(sensor);
			Poti_Set_RDAC(Potentiometer_values_B[sensor], 'B', &hspi1);

			//Read ADC (average 6 readings)
			ADC_RX_buffer_pointer = read_ADC(0x00);
			Sensor_values_B[sensor] = voltage_ADC(ADC_RX_buffer_pointer);

			// Save value as string array
			if (sensor<9)
				posB += sprintf(posB, "%.4f, ", Sensor_values_B[sensor]);
			else
				posB += sprintf(posB, "%.4f\n", Sensor_values_B[sensor]);
		}
		// Send array B
		strcat(usb_array_B, values_B);
		CDC_Transmit_FS((uint8_t *) usb_array_B, strlen(usb_array_B));
		strcpy(usb_array_B, "Array_B "); // Reset string value

		//Switch between single sensor and array mode
		if ((HAL_GPIO_ReadPin(GPIOC, Switch_Mode_Pin)) != 0){
				break;}

		// Check if a new command came over USB
		if(usb_data.new_data == 1)
		{
			decode_command(&usb_data.data[0]);
			usb_data_reset();
		}
	}
}

void read_single_sensor(){
	char usb_msg_A[10] = "SA ";
	char usb_msg_B[10] = "SB ";
	char txBuf[8];
	float measured_voltage;
	uint8_t *ADC_RX_buffer_pointer;

	mux_channel(0);
	Poti_Set_RDAC(Potentiometer_values_A[0], 'A', &hspi1);
	Poti_Set_RDAC(Potentiometer_values_B[0], 'B', &hspi1);

	while(1){
		//Read ADC value A and send via USB
		config_ADC(0x6, ADC_A_Select);
		HAL_Delay(2);
		ADC_RX_buffer_pointer = read_ADC(0x00);
		measured_voltage = voltage_ADC(ADC_RX_buffer_pointer);

		sprintf(txBuf, "%.4f\n", measured_voltage);
		strcat(usb_msg_A, txBuf);
		CDC_Transmit_FS((uint8_t *) usb_msg_A, strlen(usb_msg_A));

		strcpy(usb_msg_A, "SA "); // Reset string value

		//Read ADC value B
		config_ADC(0x6, ADC_B_Select);
		HAL_Delay(2);
		ADC_RX_buffer_pointer = read_ADC(0x00);
		measured_voltage = voltage_ADC(ADC_RX_buffer_pointer);

		sprintf(txBuf, "%.4f\n", measured_voltage);
		strcat(usb_msg_B, txBuf);
		CDC_Transmit_FS((uint8_t *) usb_msg_B, strlen(usb_msg_B));

		strcpy(usb_msg_B, "SB "); // Reset string value


		if ((HAL_GPIO_ReadPin(GPIOC, Switch_Mode_Pin)) != 1){
			break; }

		// Check if calibration button was pressed
		if ((HAL_GPIO_ReadPin(GPIOC, PushButton_Calibration_Pin)) != 1){
			calibrate_potis(&hspi1); }

		// Check if a new command came over USB   PushButton_Calibration_Pin
		if(usb_data.new_data == 1)
		{
			decode_command(&usb_data.data[0]);
			usb_data_reset();
		}


	}
}
//////////////////////////////////  End Read: Array or single sensor mode ///////////////////

////////////////////////////////// Command over USB ///////////////////
void CDC_ReceiveCallBack(uint8_t *buf, uint32_t len)
{
	memcpy(usb_data.data, buf, len);
	usb_data.new_data = 1;
	usb_data.length = len;
}

uint8_t usb_data_reset(void)
{
	uint32_t i = 0;

	for(i = 0; i<MAX_USB_BUFFER_LENGTH; i++)
	{
		usb_data.data[i] = 0;
	}
	usb_data.new_data = 0;
	return 1;
}
////////////////////////////////// END Command over USB ///////////////////

/* USER CODE END 4 */
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
