mgvargas/imsas/Code/STM32_Files/SensorArray/SensorArray.ioc

Mcu.UserName=STM32F405RGTx
PA1.GPIO_Label=ADC_Amplifier_A
PA1.Signal=ADCx_IN1
PA10.Signal=USART1_RX
PA11.Signal=USB_OTG_FS_DM
PA12.Signal=USB_OTG_FS_DP
PA13.Signal=SYS_JTMS-SWDIO
PA14.Signal=SYS_JTCK-SWCLK
PA2.GPIO_Label=ADC_Amplifier_B
PA2.Signal=ADCx_IN2
PA3.GPIO_Label=SPI2_CS_ADC
PA3.Signal=GPIO_Output
PA4.GPIO_Label=SPI1_CS
PA4.Signal=GPIO_Output
PA5.Signal=SPI1_SCK
PA6.Signal=SPI1_MISO
PA7.Signal=SPI1_MOSI
PA9.Signal=USART1_TX
PB0.GPIO_Label=SPI1_CS_POTIA
PB0.Signal=GPIO_Output
PB1.GPIO_Label=SPI1_CS_POTIB
PB1.Signal=GPIO_Output
PB10.Signal=SPI2_SCK
PB12.GPIO_Label=LED_STATUS
PB12.Signal=GPIO_Output
PB14.Signal=SPI2_MISO
PB15.Signal=SPI2_MOSI
PB3.Signal=SYS_JTDO-SWO
PB6.Signal=I2C1_SCL
PB7.Signal=I2C1_SDA
PC0.GPIO_Label=MUXA_S0
PC0.Signal=GPIO_Output
PC1.GPIO_Label=MUXA_S1
PC1.Signal=GPIO_Output
PC2.GPIO_Label=MUXA_S2
PC2.Signal=GPIO_Output
PC3.GPIO_Label=MUXA_S3
PC3.Signal=GPIO_Output
PC4.GPIO_Label=MUXB_S0
PC4.Signal=GPIO_Output
PC5.GPIO_Label=MUXB_S1
PC5.Signal=GPIO_Output
PC6.GPIO_Label=MUXB_S2
PC6.Signal=GPIO_Output
PC7.GPIO_Label=MUXB_S3
PC7.Signal=GPIO_Output
PC8.GPIO_Label=PushButton_Calibration
PC8.Signal=GPIO_Input
PC9.GPIO_Label=Switch_Mode
PC9.Signal=GPIO_Input
PH0-OSC_IN.Signal=RCC_OSC_IN
PH1-OSC_OUT.Signal=RCC_OSC_OUT
