mgvargas/imsas/Code/STM32_Files/SensorArray/Core/Inc/main.h

#define MAX_USB_BUFFER_LENGTH		256
#define MUXA_S0_Pin GPIO_PIN_0
#define MUXA_S0_GPIO_Port GPIOC
#define MUXA_S1_Pin GPIO_PIN_1
#define MUXA_S1_GPIO_Port GPIOC
#define MUXA_S2_Pin GPIO_PIN_2
#define MUXA_S2_GPIO_Port GPIOC
#define MUXA_S3_Pin GPIO_PIN_3
#define MUXA_S3_GPIO_Port GPIOC
#define ADC_Amplifier_A_Pin GPIO_PIN_1
#define ADC_Amplifier_A_GPIO_Port GPIOA
#define ADC_Amplifier_B_Pin GPIO_PIN_2
#define ADC_Amplifier_B_GPIO_Port GPIOA
#define SPI2_CS_ADC_Pin GPIO_PIN_3
#define SPI2_CS_ADC_GPIO_Port GPIOA
#define SPI1_CS_Pin GPIO_PIN_4
#define SPI1_CS_GPIO_Port GPIOA
#define MUXB_S0_Pin GPIO_PIN_4
#define MUXB_S0_GPIO_Port GPIOC
#define MUXB_S1_Pin GPIO_PIN_5
#define MUXB_S1_GPIO_Port GPIOC
#define SPI1_CS_POTIA_Pin GPIO_PIN_0
#define SPI1_CS_POTIA_GPIO_Port GPIOB
#define SPI1_CS_POTIB_Pin GPIO_PIN_1
#define SPI1_CS_POTIB_GPIO_Port GPIOB
#define LED_STATUS_Pin GPIO_PIN_12
#define LED_STATUS_GPIO_Port GPIOB
#define MUXB_S2_Pin GPIO_PIN_6
#define MUXB_S2_GPIO_Port GPIOC
#define MUXB_S3_Pin GPIO_PIN_7
#define MUXB_S3_GPIO_Port GPIOC
#define PushButton_Calibration_Pin GPIO_PIN_8
#define PushButton_Calibration_GPIO_Port GPIOC
#define Switch_Mode_Pin GPIO_PIN_9
#define Switch_Mode_GPIO_Port GPIOC
