mgvargas/imsas/Code/STM32_Files/SensorArray/Core/Inc/user_commands.h

/*
 * user_commands.h
 *
 *  Created on: 30 Jan 2021
 *      Author: Robert
 */

#ifndef SRC_USER_COMMANDS_H_
#define SRC_USER_COMMANDS_H_






uint8_t cmd_test(uint8_t id, uint8_t *buffer);
uint8_t cmd_get_poti(uint8_t id, uint8_t *buffer);
uint8_t cmd_test2(uint8_t id, uint8_t *buffer);
uint8_t cmd_test3(uint8_t id, uint8_t *buffer);
uint8_t cmd_test4(uint8_t id, uint8_t *buffer);



#endif /* SRC_USER_COMMANDS_H_ */
