mgvargas/imsas/(commit log)

2020-06-29 V1
    Amplifier circuit for the hair sensor array, select between 9 sensors or
    1
    [Measurement.sch, MeasurementR.sch, Powersupply.sch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]
2020-06-29 Add BOM and other component lists
    [SensorArray-all-pos_old.csv, SensorArray.csv, SensorArray_BOM_buy.csv, SensorArray_old.csv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]
2020-06-29 Add IMSAS logo to board
    [SensorArray-B_Cu.gbr, SensorArray-B_Mask.gbr, SensorArray-B_Paste.gbr, SensorArray-B_SilkS.gbr, SensorArray-Edge_Cuts.gbr, SensorArray-F_Cu.gbr, SensorArray-F_Mask.gbr, SensorArray-F_Paste.gbr]
2020-08-29 Blink a led
    [SensorArray_BOM_buy.csv]
2020-09-11 Cleaning repo
    [SensorArray_BOM_buy.csv]
2020-09-27 Start code for the ADC and clean repo
2020-09-27 Correcting GPIO port for the ADC
    [main.c]
2020-09-30 Updated schematic
2020-09-30 Matlab code for calculating resistance/voltage
2020-10-06 Configuring ADC, working
2020-10-09 V2 of the PCB, corrected SPI, connector and added safety diodes
    [Measurement_V2.sch, Powersupply_V2.sch, SensorArray_V2.kicad_pcb, SensorArray_v2.sch]
2020-10-30 General code structure. SPI communication not working
    [SensorArray.ioc, main.c, main.h]
2020-11-30 Add .ioc config file for the second version of the board
2020-11-30 Sent to fabrication
    [Measurement_V2.sch, Powersupply_V2.sch, SensorArray_V2.kicad_pcb, SensorArray_v2.sch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]
2020-12-07 Add PCB for sensor array chip, V1
    [PCB_Sensor_Array-B_Cu.gbr, PCB_Sensor_Array-B_Mask.gbr, PCB_Sensor_Array-B_Paste.gbr, PCB_Sensor_Array-Cmts_User.gbr, PCB_Sensor_Array-Edge_Cuts.gbr, PCB_Sensor_Array-F_Cu.gbr, PCB_Sensor_Array-F_Mask.gbr, PCB_Sensor_Array-F_Paste.gbr]
2020-12-07 Adjust hole size (4mm -> 4.2mm)
    [PCB_Sensor_Array.kicad_pcb]
2021-01-05 Add ADC datasheet, update MX file for second board version
2021-01-13 Create folder for interface of the board with the PC
2021-01-19 Fixing USB communication bug, now it is always recognized. Lowering CLK freq to 84MHz, I have to test if 164HZ also work
    [SensorArray.ioc, main.c]
2021-01-23 Added Functionality
    [Sensor-A-15 19-23-1-2021.xlsx, Sensor-B-15 19-23-1-2021.xlsx]
2021-01-25 Removing warnings, reading ADC, but it does not always work
2021-01-25 ADC working, sends value over USB
2021-01-27 Removing scan register configuration for teh ADC, delete later
2021-01-28 Added some datasheets and logos for the PCB
2021-01-29 Updated GUI
    [Sensor-A1B1-01 00-29-1-2021.xlsx, Sensor-B-00 33-29-1-2021.xlsx]
2021-01-30 Test sending ADC values to GUI
2021-01-30 Calibrating and reading single sensor, sending over USB
2021-01-31 Changed Line Chart to Spline, added IMSAS Icon
    [Sensor-AB-19 34-29-1-2021.xlsx]
2021-01-31 Splitting main.c in several files: ADC, calibration, Potentiometer, multiplexor. Reads and calibrates 1 sensor
2021-02-04 Added CSV Button Option
    [Sensor-A1B1-01 00-29-1-2021.xlsx, Sensor-AB-19 34-29-1-2021.xlsx, Sensor-B-00 33-29-1-2021.xlsx]
2021-02-12 Removed Exceptions
    [Sensor-B-12 27-12-2-2021.xlsx]
2021-02-19 Reading sensor array and sending the values as float array
2021-02-22 Correcting calibration, works for sensors without hairs. Reducing oversampling rate for ADC.
    [AD5270.c, SensorArray.ioc, calibration.c, main.c]
2021-02-24 Increased Serial Recording
    [Sensor-A1B1-22 40-24-2-2021.xlsx, Sensor-AB-22 46-24-2-2021.xlsx]
2021-03-01 Updated Time Column
    [Sensor-A1B1-22 40-24-2-2021.xlsx, Sensor-AB-22 46-24-2-2021.xlsx, Sensor-B-12 27-12-2-2021.xlsx]
2021-03-10 Update Matlab code to calculate needed resistance
2021-06-25 Modified Timers
2021-07-14 Activating calibration button. Error in PCB detected, the button is not grounded, but it kinda works.
    [calibration.c, main.c]
2021-07-14 Add milling file for the PCB (CNC machine, AVT 0)
    [Mill_PCB_Senso.kicad_pcb]
